moormanlab/miniscope-goodies/README.md

# miniscope-goodies
A place for goodies for miniscope project
