moormanlab/miniscope-goodies/3Dmodels/stls/miniscopeV4Holder.stl

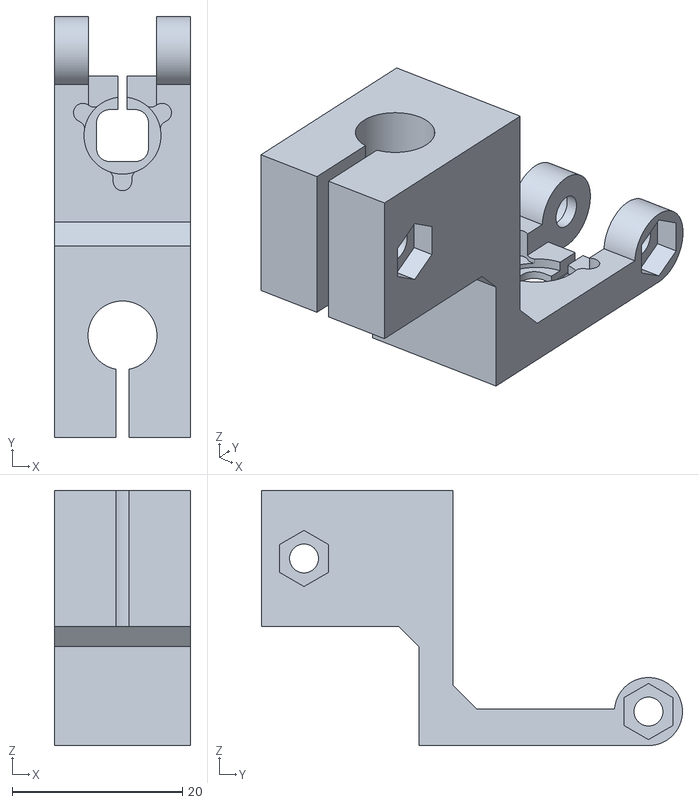
[picture p1: CAD file, 2021-05-07]
3Dmodels/stls/miniscopeV4Holder.stl
16.0 x 49.5 x 30.0
