moormanlab/miniscope-goodies/3Dmodels/stls/cap.stl

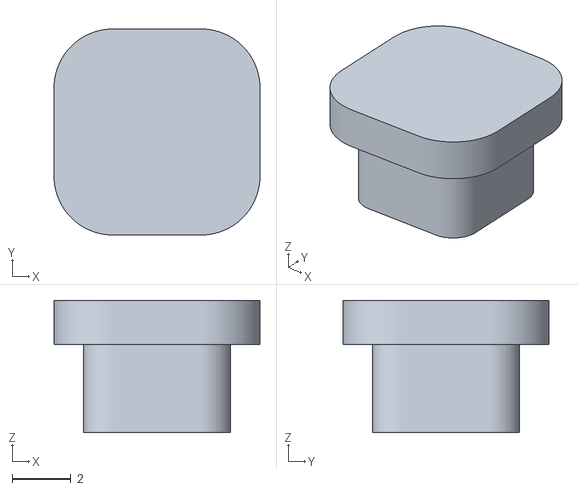
[picture p2: CAD file, 2021-05-07]
3Dmodels/stls/cap.stl
7.00 x 7.00 x 4.50
