moormanlab/miniscope-goodies/3Dmodels/stls/lensholder_1.0_2.0.stl

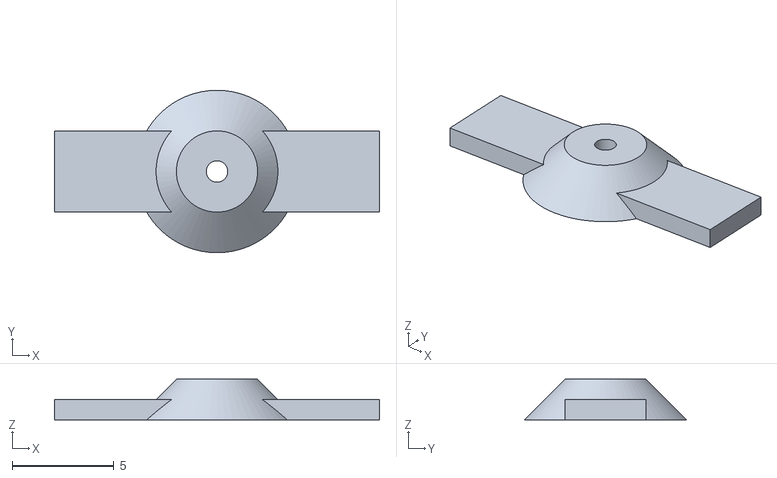
[picture p3: CAD file, 2021-05-07]
3Dmodels/stls/lensholder_1.0_2.0.stl
16.0 x 8.00 x 2.00
