moormanlab/miniscope-goodies/3Dmodels/stls/baseplateholder.stl

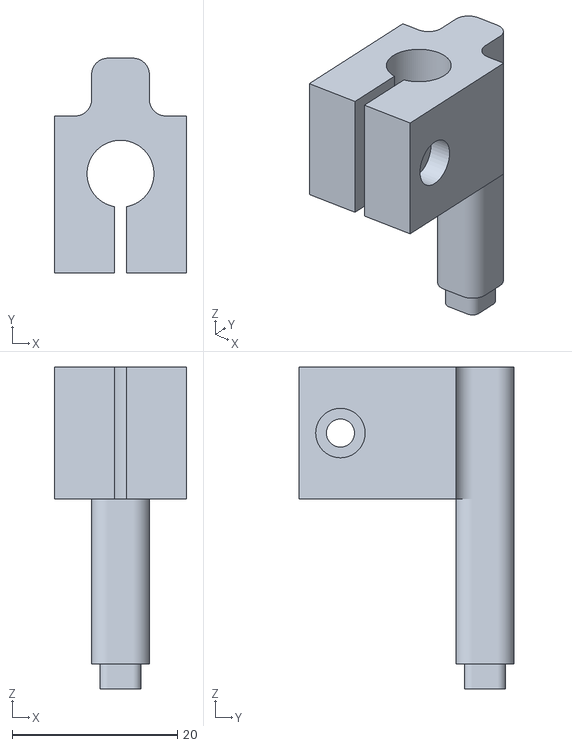
[picture p4: CAD file, 2021-05-07]
3Dmodels/stls/baseplateholder.stl
16.0 x 26.0 x 39.0
