moormanlab/miniscope-goodies/3Dmodels/stls/baseplate_1.0_0.3_1.0.stl

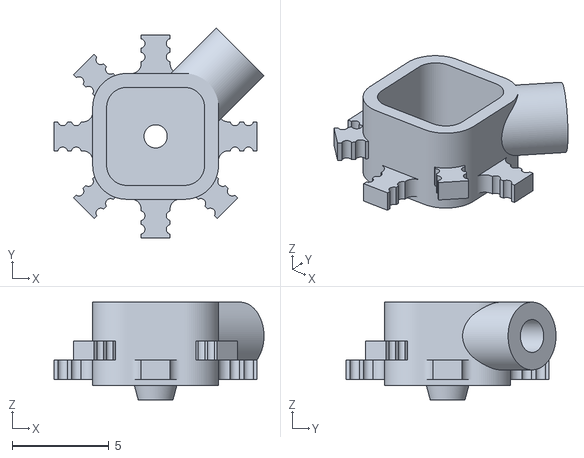
[picture p5: CAD file, 2021-05-07]
3Dmodels/stls/baseplate_1.0_0.3_1.0.stl
10.8 x 10.8 x 5.05
