moormanlab/miniscope-goodies/(commit log)

2021-02-12 baseplate openscad model
    [baseplate.scad]
2021-02-12 stl model
    [baseplate1050.stl]
2021-02-14 added gap as parameter, between baseplate and miniscope
    [baseplate.scad]
2021-03-26 baseplate 1.1 and added sterotaxic holder for miniscope and baseplate
    [baseplate.scad, miniscopeV4Holder.scad, utils.scad]
2021-04-27 updated stl
    [baseplate1050.stl, baseplate_L1mm.stl]
2021-05-07 reorganized modules
    [baseplate.scad, baseplateholder.scad, lenses.scad, miniscopeV4Holder.scad, utils.scad]
2021-05-07 clean up
    [baseplate.scad]
2021-05-07 more cleanup
    [lenses.scad]
2021-05-07 added STL from updated files
    [baseplate_1.0_0.3_1.0.stl, baseplate_L1mm.stl, baseplateholder.stl, cap.stl, lensholder_1.0_2.0.stl, miniscopeV4Holder.stl]
2021-05-11 first version of prism lenses, didnt work
    [lenses.scad]
2021-06-02 added prism lens alineation models
    [lenses.scad]
2022-05-04 added prism lenses and slide holder
    [baseplate.scad, lenses.scad, utils.scad]
